Gumball2415/NES-Famicom-Cartridge-PCBs/README.md

# NES-Famicom-Cartridge-PCBs

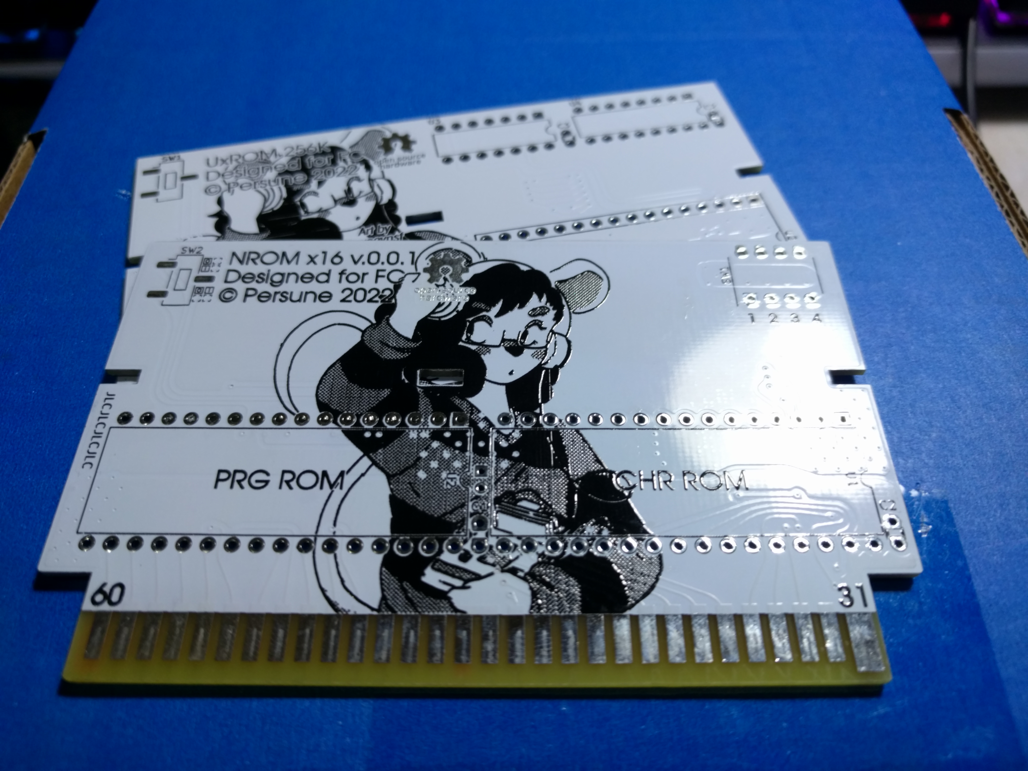
[picture p1: docs/overview.jpg]
 
 
 this is where i make the famicom cartridge PCBs
 
 All cartridge PCBs are licenced under the TAPR Open Hardware License.
 All software tools distributed with each project are licensed under the MIT-0 License.
 
 ## Support

If you enjoy this project or find it helpful, please support me on [Ko-Fi](https://ko-fi.com/persune) or [Patreon](https://www.patreon.com/persune)!
