Gumball2415/NES-Famicom-Cartridge-PCBs/nrom-board/nrom-board.kicad_pcb

## KiCad design nrom-board/nrom-board.kicad_pcb (2022-11-25)

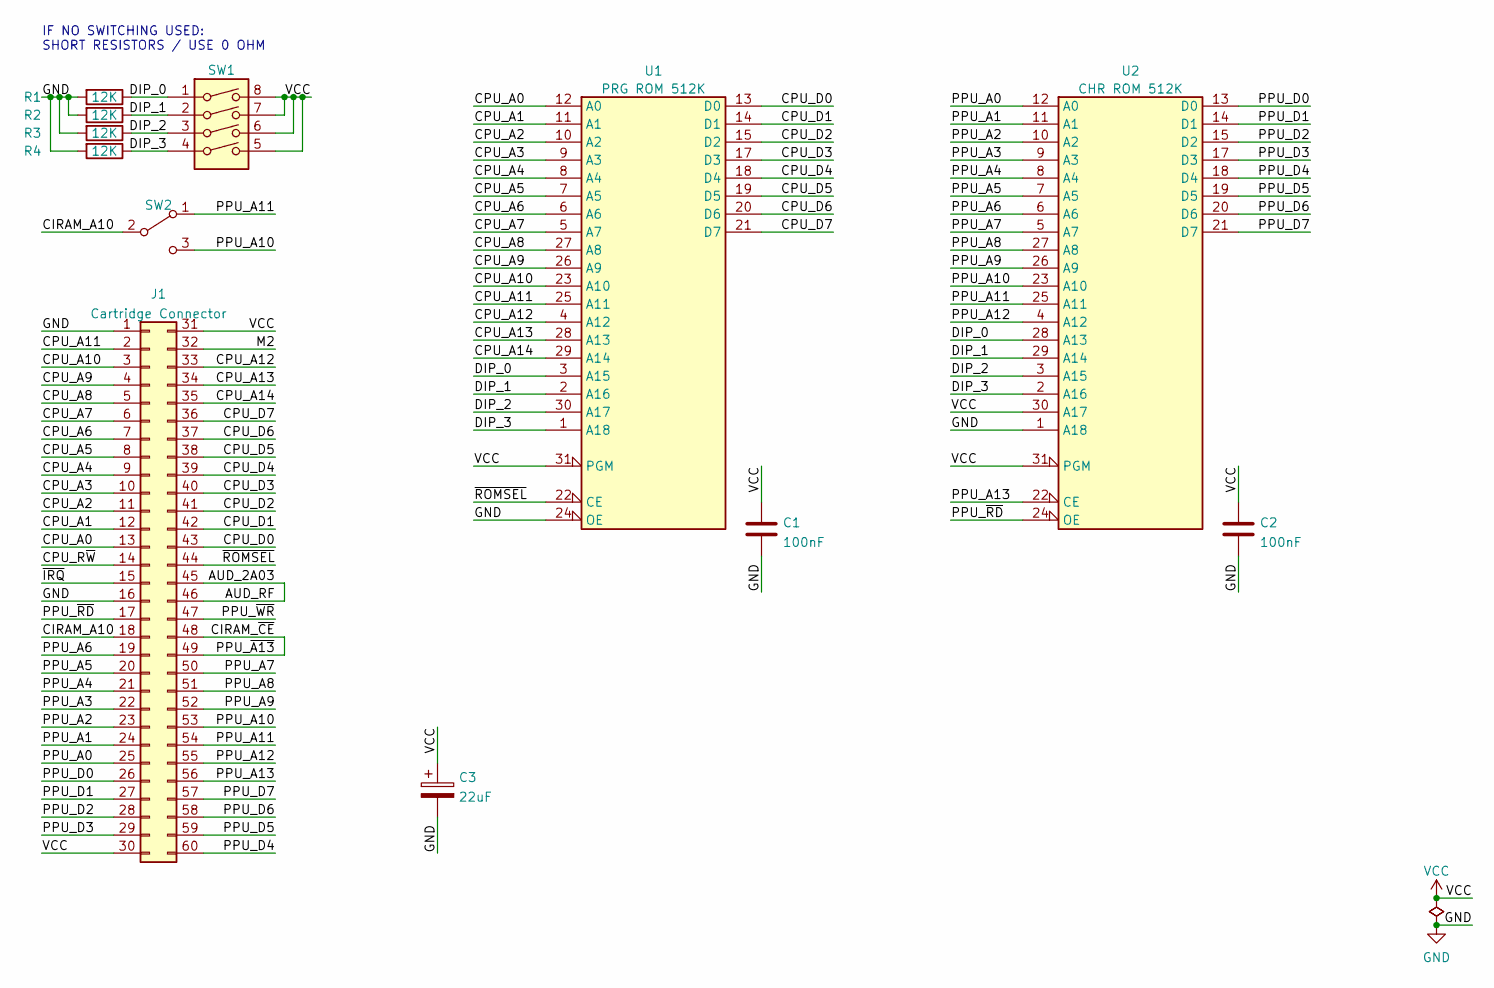
[picture p2: schematic nrom-board.kicad_sch, FC NROM 256x16 Board]

Parts:
C1, C2: 100nF; C_Disc-0805_D3.0mm_W1.6mm_P2.50mm
C3: 22uF; CP_Radial_D4.0mm_P2.00mm
J1: Cartridge Connector; HVC-TGROM-01
R1, R2, R3, R4: 12K; R_0805_2012Metric
SW1: SW_DIP_x04; DS04-254-2-04BK-SMT-ND
SW2: SW_SPDT; JS102011SCQN
U1: PRG ROM 512K; DIP-32_W15.24mm
U2: CHR ROM 512K; DIP-32_W15.24mm

Connections:
/AUD_2A03: J1.45, J1.46
/CIRAM_A10: J1.18, SW2.2 (B)
/CIRAM_~CE: J1.48, J1.49
/CPU_A0: J1.13, U1.12 (A0)
/CPU_A1: J1.12, U1.11 (A1)
/CPU_A2: J1.11, U1.10 (A2)
/CPU_A3: J1.10, U1.9 (A3)
/CPU_A4: J1.9, U1.8 (A4)
/CPU_A5: J1.8, U1.7 (A5)
/CPU_A6: J1.7, U1.6 (A6)
/CPU_A7: J1.6, U1.5 (A7)
/CPU_A8: J1.5, U1.27 (A8)
/CPU_A9: J1.4, U1.26 (A9)
/CPU_A10: J1.3, U1.23 (A10)
/CPU_A11: J1.2, U1.25 (A11)
/CPU_A12: J1.33, U1.4 (A12)
/CPU_A13: J1.34, U1.28 (A13)
/CPU_A14: J1.35, U1.29 (A14)
/CPU_D0: J1.43, U1.13 (D0)
/CPU_D1: J1.42, U1.14 (D1)
/CPU_D2: J1.41, U1.15 (D2)
/CPU_D3: J1.40, U1.17 (D3)
/CPU_D4: J1.39, U1.18 (D4)
/CPU_D5: J1.38, U1.19 (D5)
/CPU_D6: J1.37, U1.20 (D6)
/CPU_D7: J1.36, U1.21 (D7)
/CPU_R~W: J1.14
/DIP_0: R1.1, SW1.1, U1.3 (A15), U2.28 (A13)
/DIP_1: R2.1, SW1.2, U1.2 (A16), U2.29 (A14)
/DIP_2: R3.1, SW1.3, U1.30 (A17), U2.3 (A15)
/DIP_3: R4.1, SW1.4, U1.1 (A18), U2.2 (A16)
/M2: J1.32
/PPU_A0: J1.25, U2.12 (A0)
/PPU_A1: J1.24, U2.11 (A1)
/PPU_A2: J1.23, U2.10 (A2)
/PPU_A3: J1.22, U2.9 (A3)
/PPU_A4: J1.21, U2.8 (A4)
/PPU_A5: J1.20, U2.7 (A5)
/PPU_A6: J1.19, U2.6 (A6)
/PPU_A7: J1.50, U2.5 (A7)
/PPU_A8: J1.51, U2.27 (A8)
/PPU_A9: J1.52, U2.26 (A9)
/PPU_A10: J1.53, SW2.3 (C), U2.23 (A10)
/PPU_A11: J1.54, SW2.1 (A), U2.25 (A11)
/PPU_A12: J1.55, U2.4 (A12)
/PPU_A13: J1.56, U2.22 (CE)
/PPU_D0: J1.26, U2.13 (D0)
/PPU_D1: J1.27, U2.14 (D1)
/PPU_D2: J1.28, U2.15 (D2)
/PPU_D3: J1.29, U2.17 (D3)
/PPU_D4: J1.60, U2.18 (D4)
/PPU_D5: J1.59, U2.19 (D5)
/PPU_D6: J1.58, U2.20 (D6)
/PPU_D7: J1.57, U2.21 (D7)
/PPU_~RD: J1.17, U2.24 (OE)
/PPU_~WR: J1.47
/~IRQ: J1.15
/~ROMSEL: J1.44, U1.22 (CE)
GND: C1.2, C2.2, C3.2, J1.1, J1.16, R1.2, R2.2, R3.2, R4.2, U1.16 (GND), U1.24 (OE), U2.1 (A18), U2.16 (GND)
VCC: C1.1, C2.1, C3.1, J1.30, J1.31, SW1.5, SW1.6, SW1.7, SW1.8, U1.31 (PGM), U1.32 (VCC), U2.30 (A17), U2.31 (PGM), U2.32 (VCC)

Notes on the sheet:
IF NO SWITCHING USED: SHORT RESISTORS / USE 0 OHM

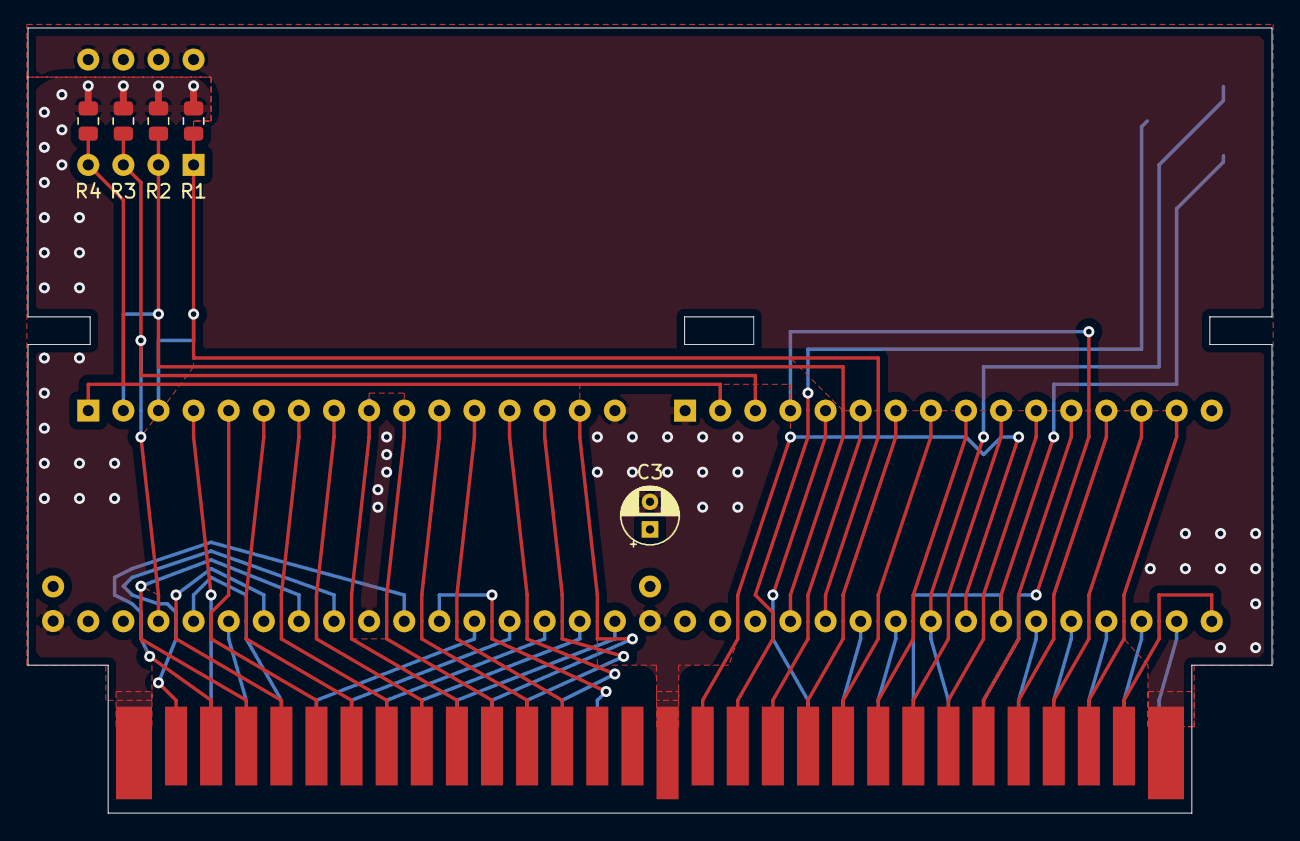
[picture p3: board nrom-board.kicad_pcb from above]

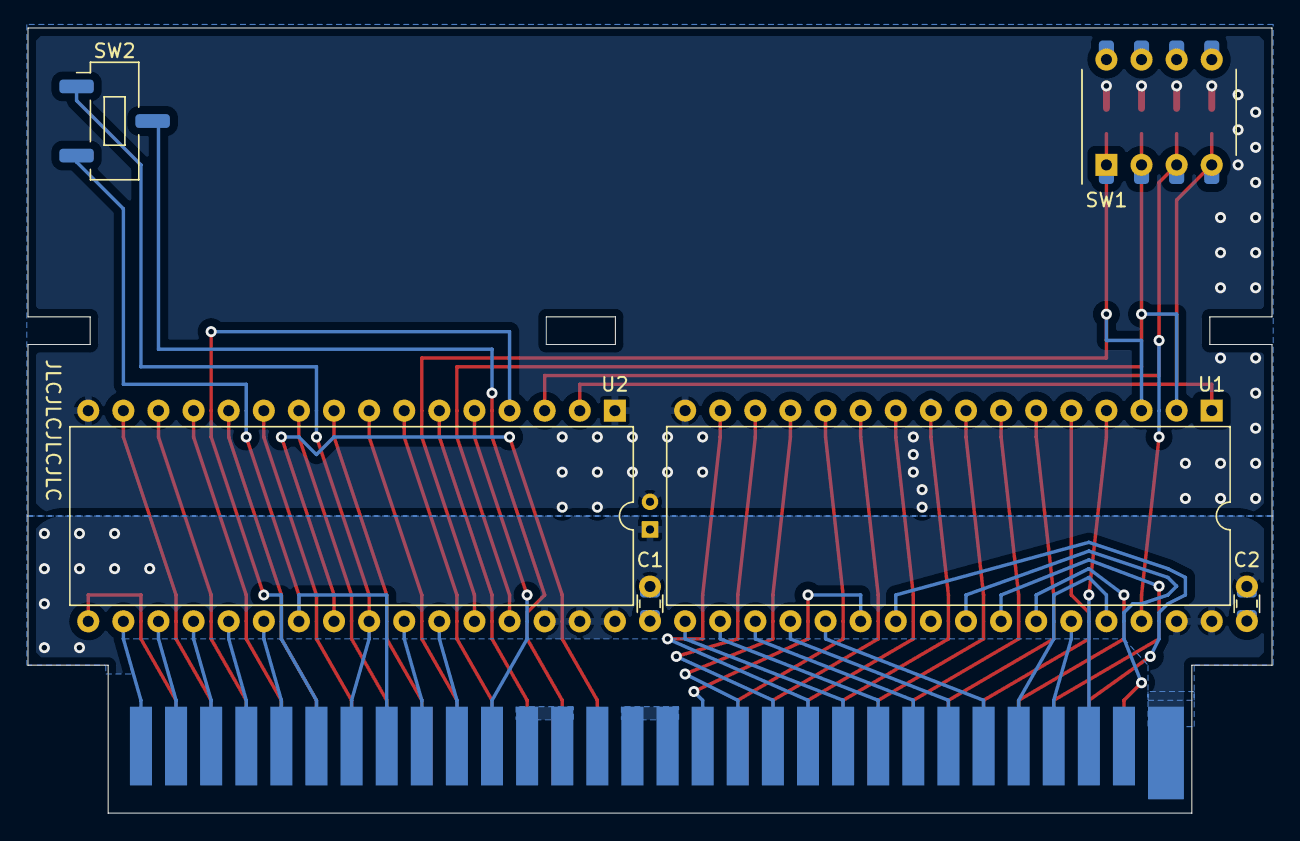
[picture p4: board nrom-board.kicad_pcb from below]

Board: 2 copper layers, 90.0 x 56.8 mm, 12 parts (6 on the bottom side), 56 nets.
