Gumball2415/NES-Famicom-Cartridge-PCBs/unrom-board/unrom-board.kicad_pcb

## KiCad design unrom-board/unrom-board.kicad_pcb (2022-11-23)

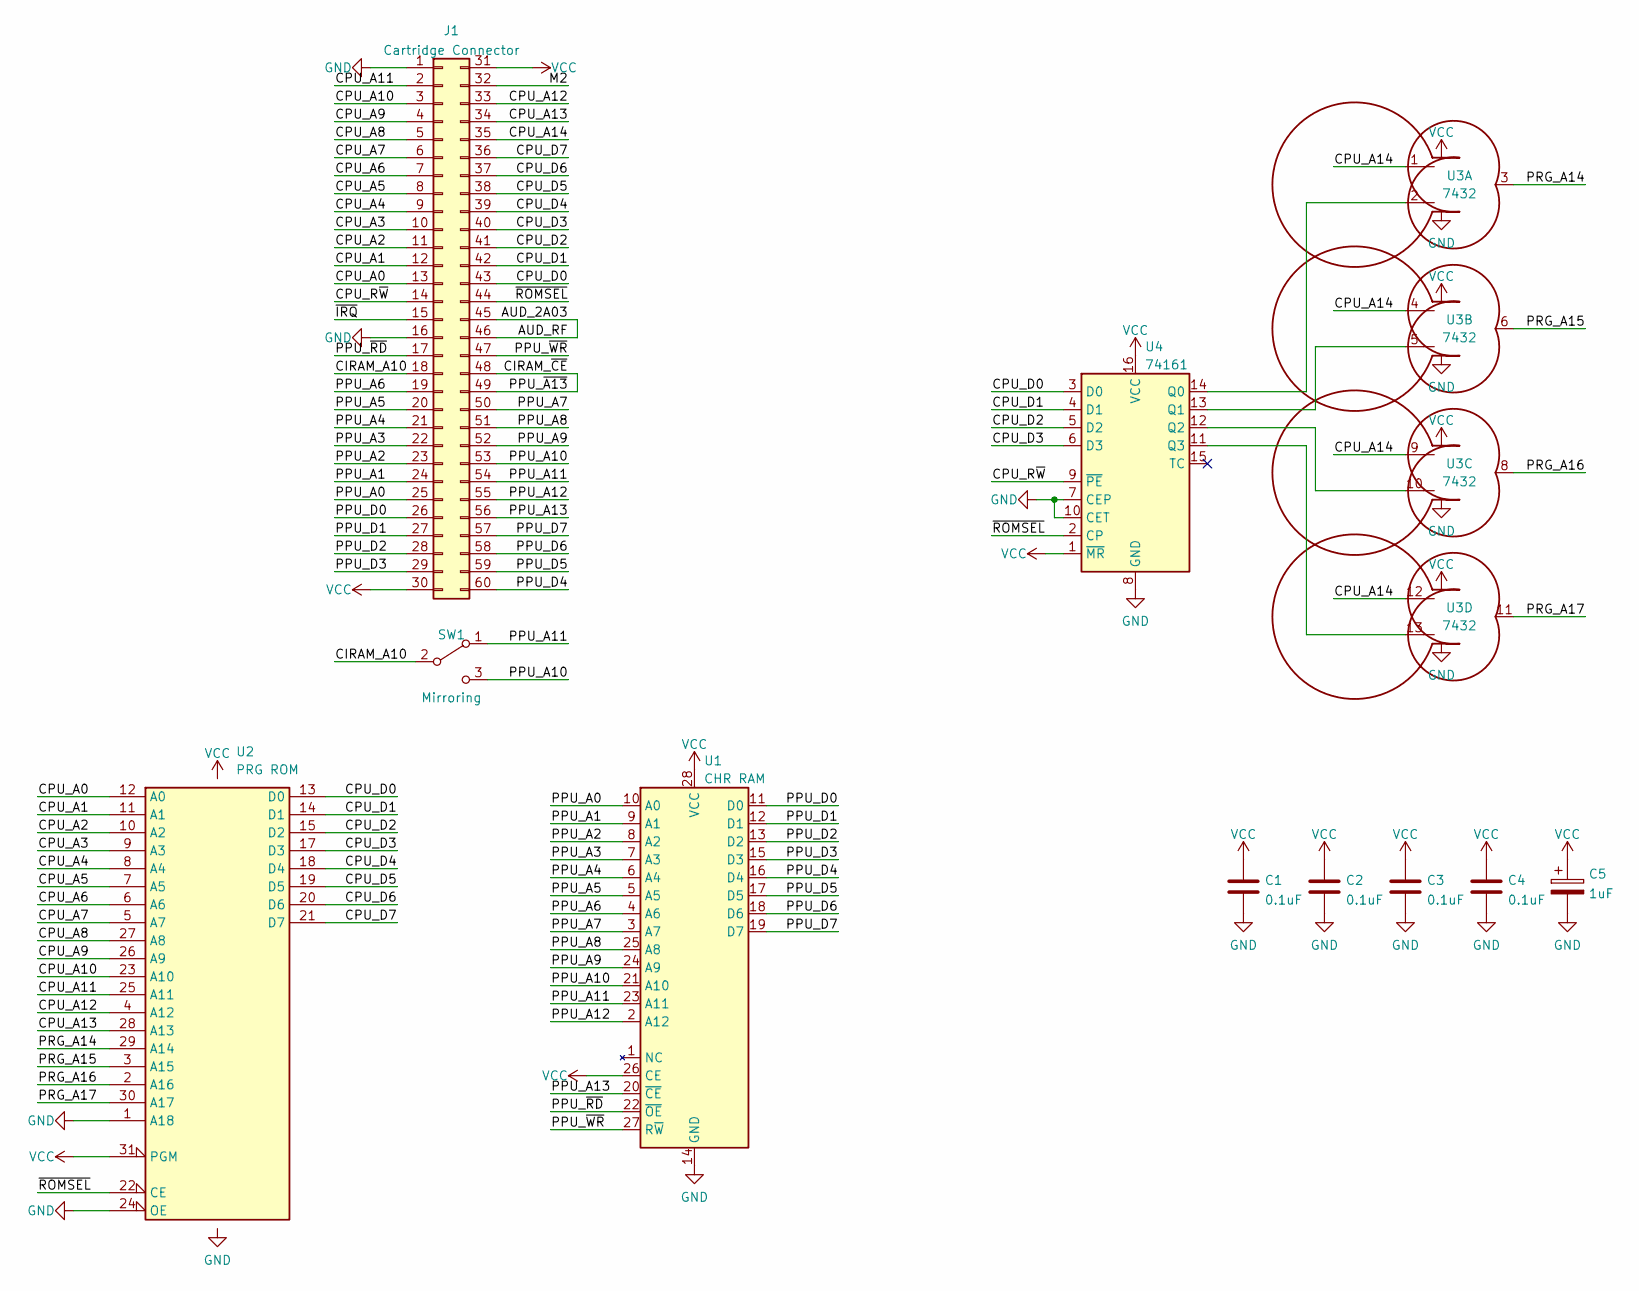
[picture p5: schematic unrom-board.kicad_sch, UNROM/UOROM Board]

Parts:
C1, C2, C3, C4: 0.1uF
C5: 1uF; CP_Radial_D4.0mm_P2.00mm
J1: Cartridge Connector
SW1: Mirroring
U1: CHR RAM; DIP-28_W15.24mm_Socket
U2: PRG ROM; DIP-32_W15.24mm_Socket
U3: 7432; DIP-14_W7.62mm
U4: 74161; DIP-16_W7.62mm

Connections:
/AUD_2A03: J1.45, J1.46
/CIRAM_A10: J1.18, SW1.2 (B)
/CIRAM_~CE: J1.48, J1.49
/CPU_A0: J1.13, U2.12 (A0)
/CPU_A1: J1.12, U2.11 (A1)
/CPU_A2: J1.11, U2.10 (A2)
/CPU_A3: J1.10, U2.9 (A3)
/CPU_A4: J1.9, U2.8 (A4)
/CPU_A5: J1.8, U2.7 (A5)
/CPU_A6: J1.7, U2.6 (A6)
/CPU_A7: J1.6, U2.5 (A7)
/CPU_A8: J1.5, U2.27 (A8)
/CPU_A9: J1.4, U2.26 (A9)
/CPU_A10: J1.3, U2.23 (A10)
/CPU_A11: J1.2, U2.25 (A11)
/CPU_A12: J1.33, U2.4 (A12)
/CPU_A13: J1.34, U2.28 (A13)
/CPU_A14: J1.35, U3.1, U3.4, U3.9, U3.12
/CPU_D0: J1.43, U2.13 (D0), U4.3 (D0)
/CPU_D1: J1.42, U2.14 (D1), U4.4 (D1)
/CPU_D2: J1.41, U2.15 (D2), U4.5 (D2)
/CPU_D3: J1.40, U2.17 (D3), U4.6 (D3)
/CPU_D4: J1.39, U2.18 (D4)
/CPU_D5: J1.38, U2.19 (D5)
/CPU_D6: J1.37, U2.20 (D6)
/CPU_D7: J1.36, U2.21 (D7)
/CPU_R~W: J1.14, U4.9 (~PE)
/M2: J1.32
/PPU_A0: J1.25, U1.10 (A0)
/PPU_A1: J1.24, U1.9 (A1)
/PPU_A2: J1.23, U1.8 (A2)
/PPU_A3: J1.22, U1.7 (A3)
/PPU_A4: J1.21, U1.6 (A4)
/PPU_A5: J1.20, U1.5 (A5)
/PPU_A6: J1.19, U1.4 (A6)
/PPU_A7: J1.50, U1.3 (A7)
/PPU_A8: J1.51, U1.25 (A8)
/PPU_A9: J1.52, U1.24 (A9)
/PPU_A10: J1.53, SW1.3 (C), U1.21 (A10)
/PPU_A11: J1.54, SW1.1 (A), U1.23 (A11)
/PPU_A12: J1.55, U1.2 (A12)
/PPU_A13: J1.56, U1.20 (~CE)
/PPU_D0: J1.26, U1.11 (D0)
/PPU_D1: J1.27, U1.12 (D1)
/PPU_D2: J1.28, U1.13 (D2)
/PPU_D3: J1.29, U1.15 (D3)
/PPU_D4: J1.60, U1.16 (D4)
/PPU_D5: J1.59, U1.17 (D5)
/PPU_D6: J1.58, U1.18 (D6)
/PPU_D7: J1.57, U1.19 (D7)
/PPU_~RD: J1.17, U1.22 (~OE)
/PPU_~WR: J1.47, U1.27 (R~W)
/PRG_A14: U2.29 (A14), U3.3
/PRG_A15: U2.3 (A15), U3.6
/PRG_A16: U2.2 (A16), U3.8
/PRG_A17: U2.30 (A17), U3.11
/~IRQ: J1.15
/~ROMSEL: J1.44, U2.22 (CE), U4.2 (CP)
GND: C1.2, C2.2, C3.2, C4.2, C5.2, J1.1, J1.16, U1.14 (GND), U2.1 (A18), U2.16 (GND), U2.24 (OE), U3.7 (GND), U4.7 (CEP), U4.8 (GND), U4.10 (CET)
unnamed: U3.2, U4.14 (Q0)
unnamed: U3.5, U4.13 (Q1)
unnamed: U3.10, U4.12 (Q2)
unnamed: U3.13, U4.11 (Q3)
VCC: C1.1, C2.1, C3.1, C4.1, C5.1, J1.30, J1.31, U1.26 (CE), U1.28 (VCC), U2.31 (PGM), U2.32 (VCC), U3.14 (VCC), U4.1 (~MR), U4.16 (VCC)

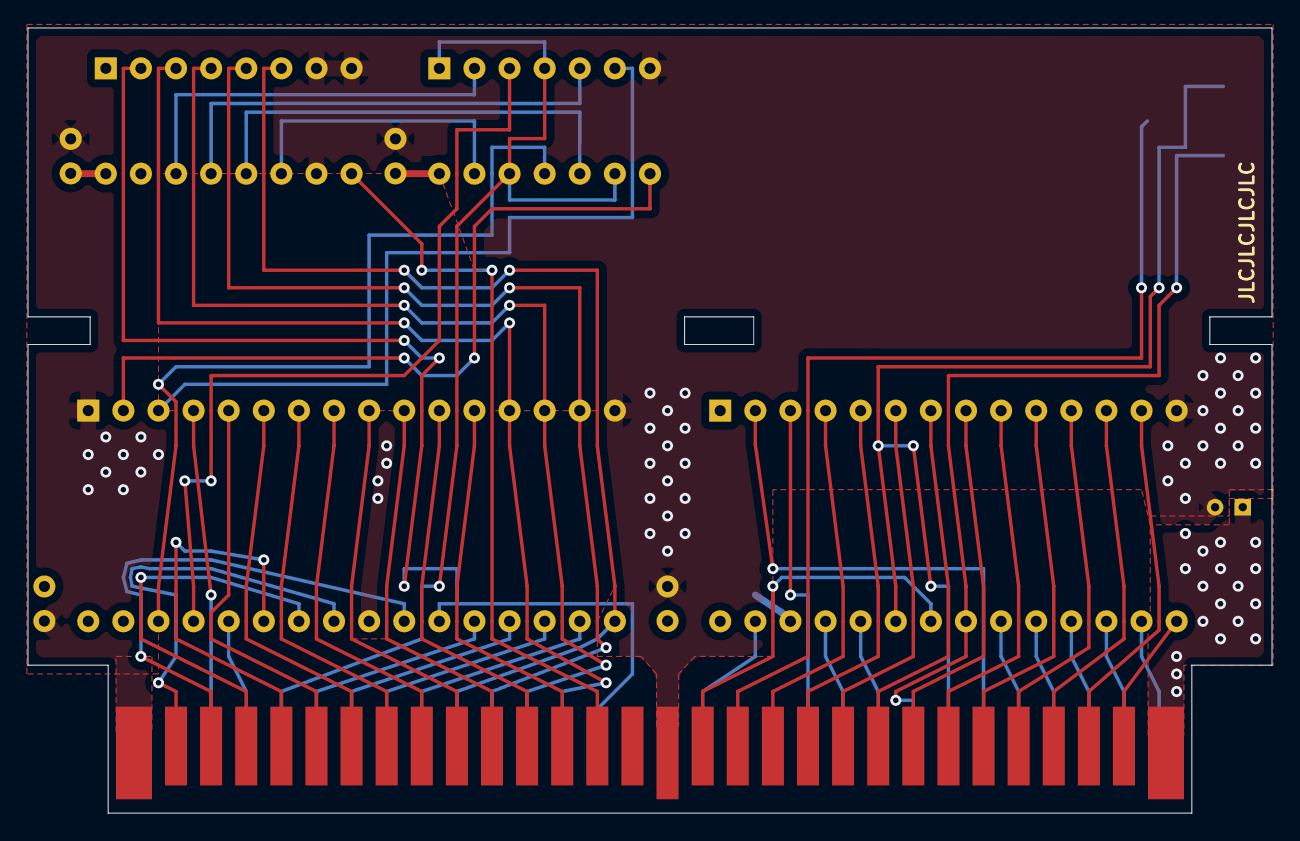
[picture p6: board unrom-board.kicad_pcb from above]

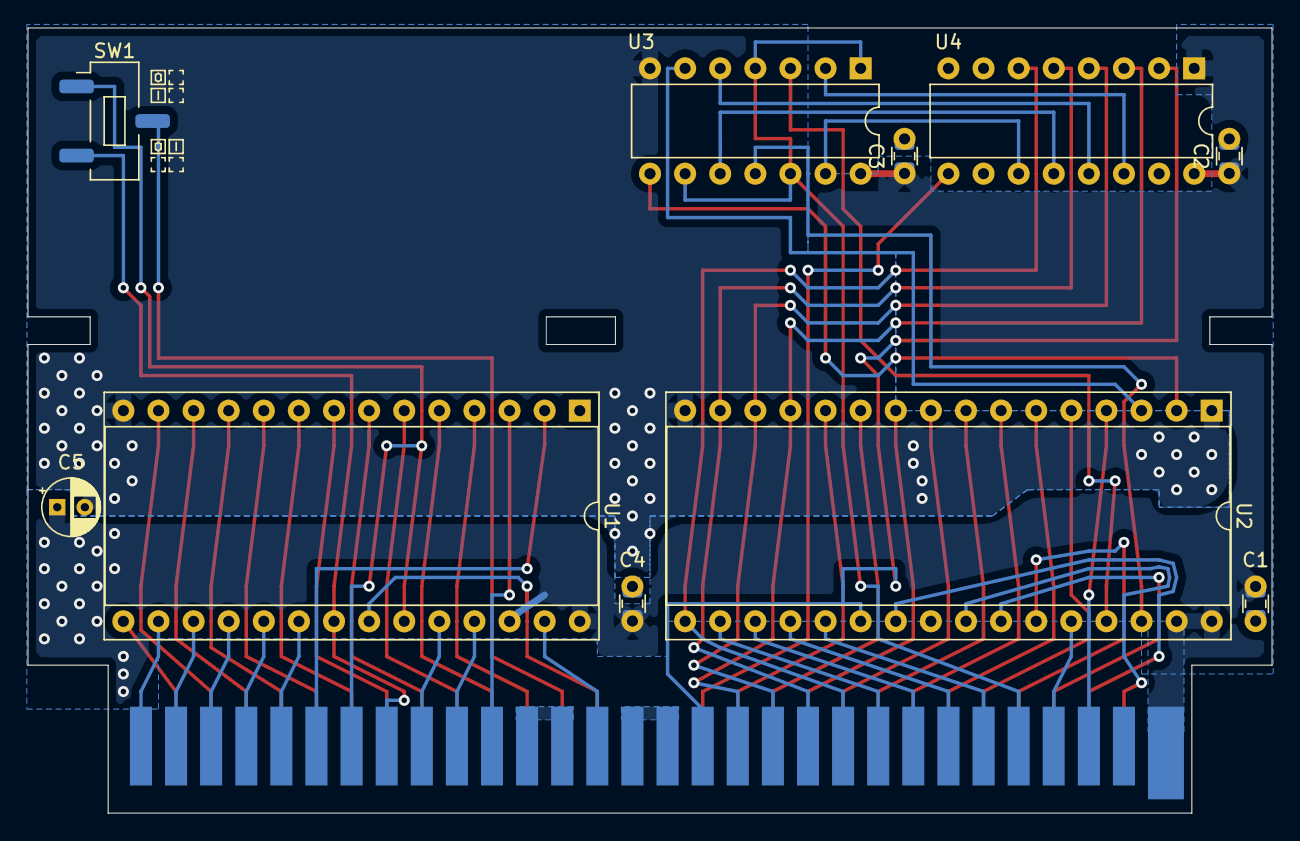
[picture p7: board unrom-board.kicad_pcb from below]

Board: 2 copper layers, 90.0 x 56.8 mm, 11 parts (10 on the bottom side), 62 nets.
