Gumball2415/NES-Famicom-Cartridge-PCBs/(commit log)

2022-11-23 NROM x16: Initial commit
    [nrom-board-rounded.kicad_pcb, nrom-board.kicad_pcb, nrom-board.kicad_sch]
2022-11-23 UxROM 256K: Initial commit
    [unrom-board-rounded.kicad_pcb, unrom-board.kicad_pcb, unrom-board.kicad_sch]
2022-11-25 NROM x16: Refactor ROM bankswitching circuit
    - Refactor routing
    [nrom-board-rounded.kicad_pcb, nrom-board.kicad_pcb, nrom-board.kicad_sch]
